X-Green/ELEC3300-Maglev-Project-2025/maglev2025_software/checklist.md

# Features

- ⚪️ADC Reading
  - CoilCurrent
  - InputVoltage
  - OverallCurrent
- ⚪️Coil Driving
- ⚪️MAG Reading
- ⚪️POSITION Control
- ⚪️RGB
- ⚪️Buzzer
- ⚪️Rotary Encoder
- ⚪️Voice UART
- ⚪️OLED
