X-Green/ELEC3300-Maglev-Project-2025/maglev2025_mech/Base_board/Base_board_3DP.SLDPRT

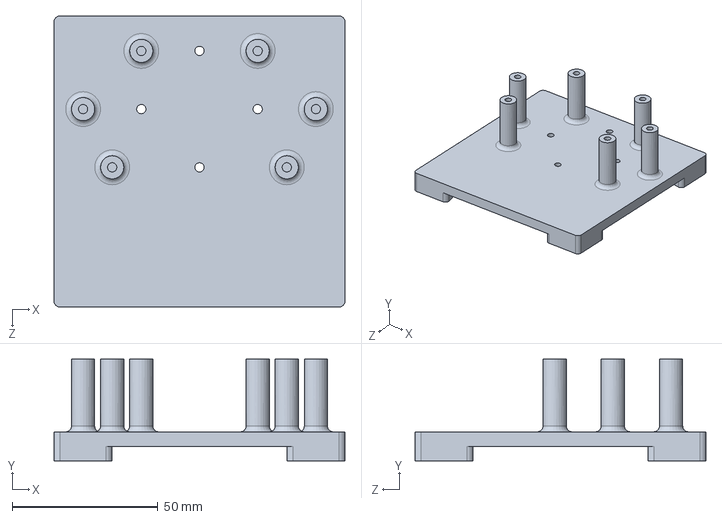
[picture p1: CAD file, 2025-04-16]
maglev2025_mech/Base_board/Base_board_3DP.SLDPRT
100.0 x 35.0 x 100.0 mm
