X-Green/ELEC3300-Maglev-Project-2025/maglev2025_hardware_sensor/maglev2025_hardware_sensor.kicad_pcb

## KiCad design maglev2025_hardware_sensor/maglev2025_hardware_sensor.kicad_pcb (2025-04-24)

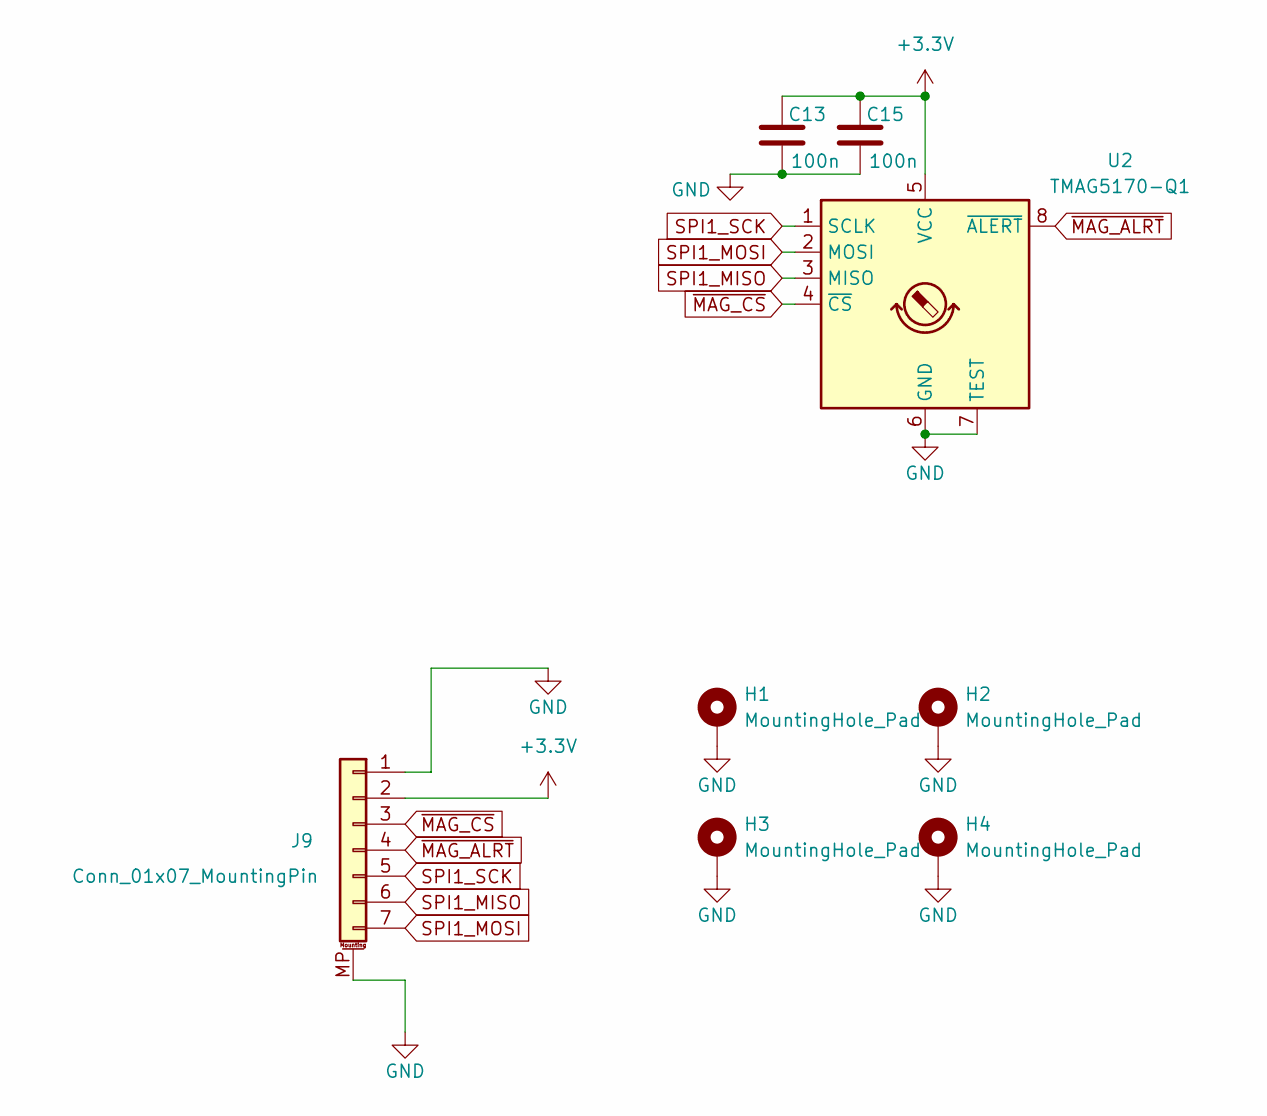
[picture p2: schematic maglev2025_hardware_sensor.kicad_sch]

Parts:
C13, C15: 100n; C_0603_1608Metric
H1, H2, H3, H4: MountingHole_Pad; MountingHole_2.2mm_M2_Pad_Via
J9: Conn_01x07_MountingPin; JST_GH_SM07B-GHS-TB_1x07-1MP_P1.25mm_Horizontal
U2: TMAG5170-Q1; VSSOP-8_3x3mm_P0.65mm

Connections:
+3.3V: C13.1, C15.1, J9.2, U2.5 (VCC)
GND: C13.2, C15.2, H1.1, H2.1, H3.1, H4.1, J9.1, J9.MP (MountPin), U2.6 (GND), U2.7 (TEST)
SPI1_MISO: J9.6, U2.3 (MISO)
SPI1_MOSI: J9.7, U2.2 (MOSI)
SPI1_SCK: J9.5, U2.1 (SCLK)
~MAG_ALRT: J9.4, U2.8 (~ALERT)
~MAG_CS: J9.3, U2.4 (~CS)

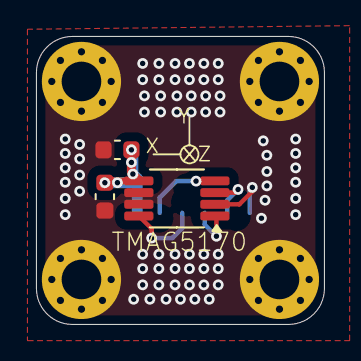
[picture p3: board maglev2025_hardware_sensor.kicad_pcb from above]

Board: 2 copper layers, 16.0 x 16.0 mm, 8 parts (1 on the bottom side), 7 nets.
