X-Green/ELEC3300-Maglev-Project-2025/maglev2025_hardware_test2/maglev2025_hardware_test2.kicad_pcb

## KiCad design maglev2025_hardware_test2/maglev2025_hardware_test2.kicad_pcb (2025-04-24)

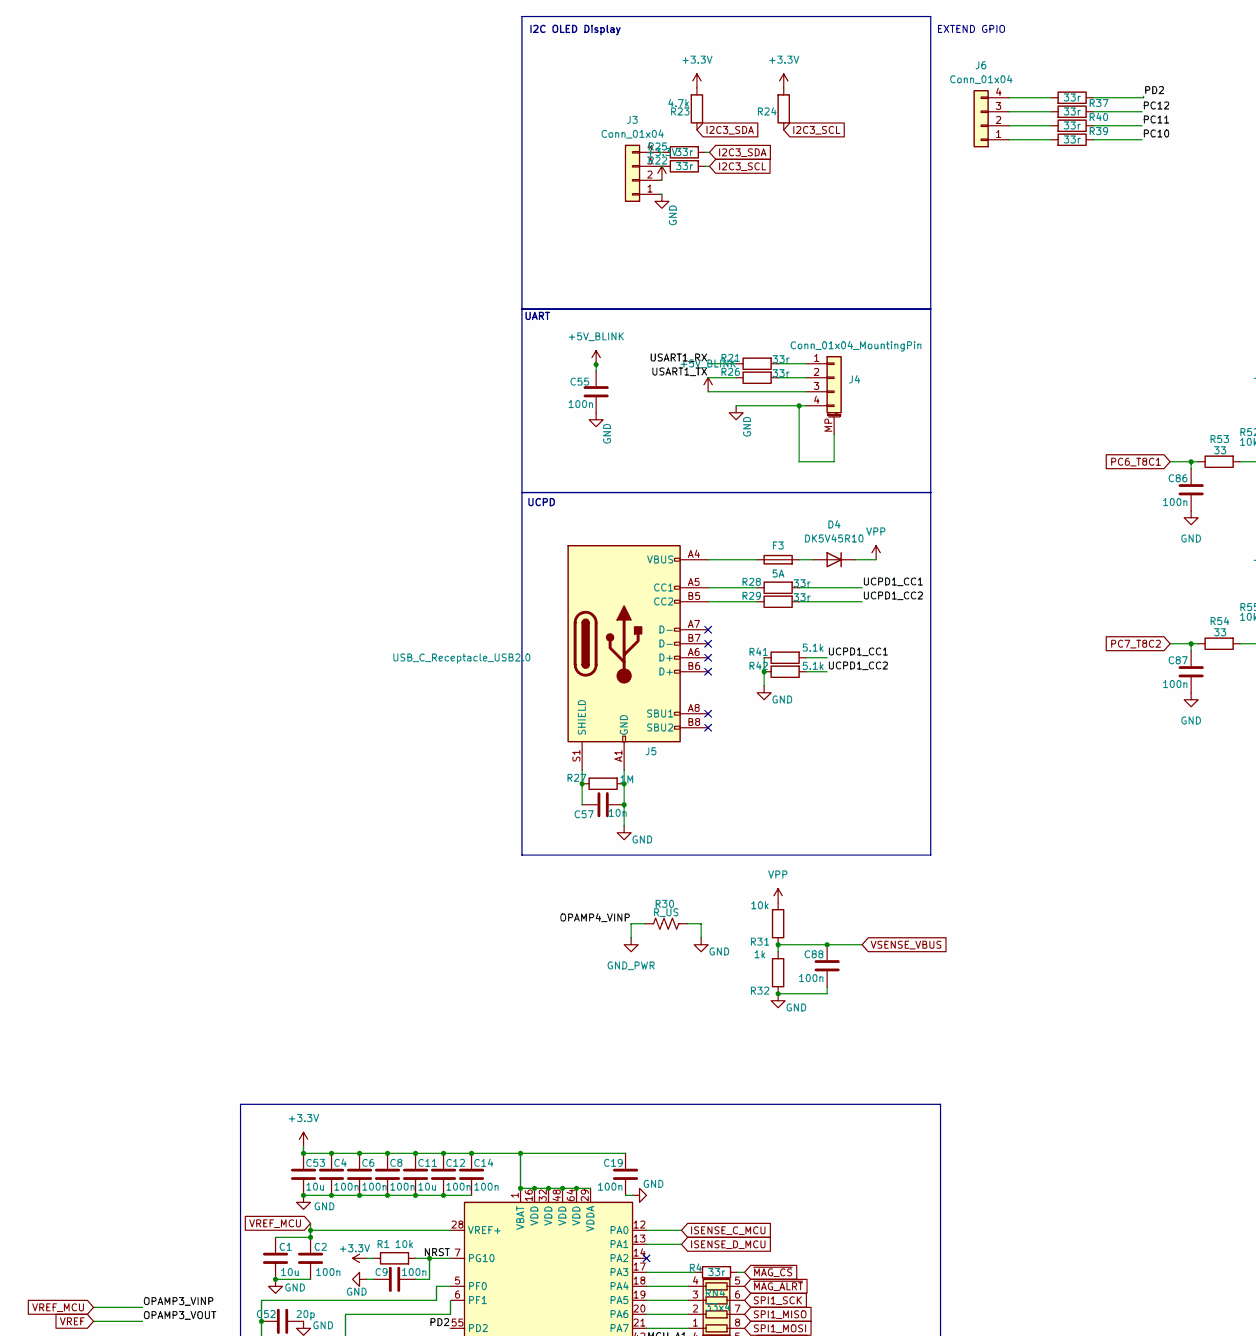
[picture p4: schematic maglev2025_hardware_test2.kicad_sch, part in row 1, column 1]

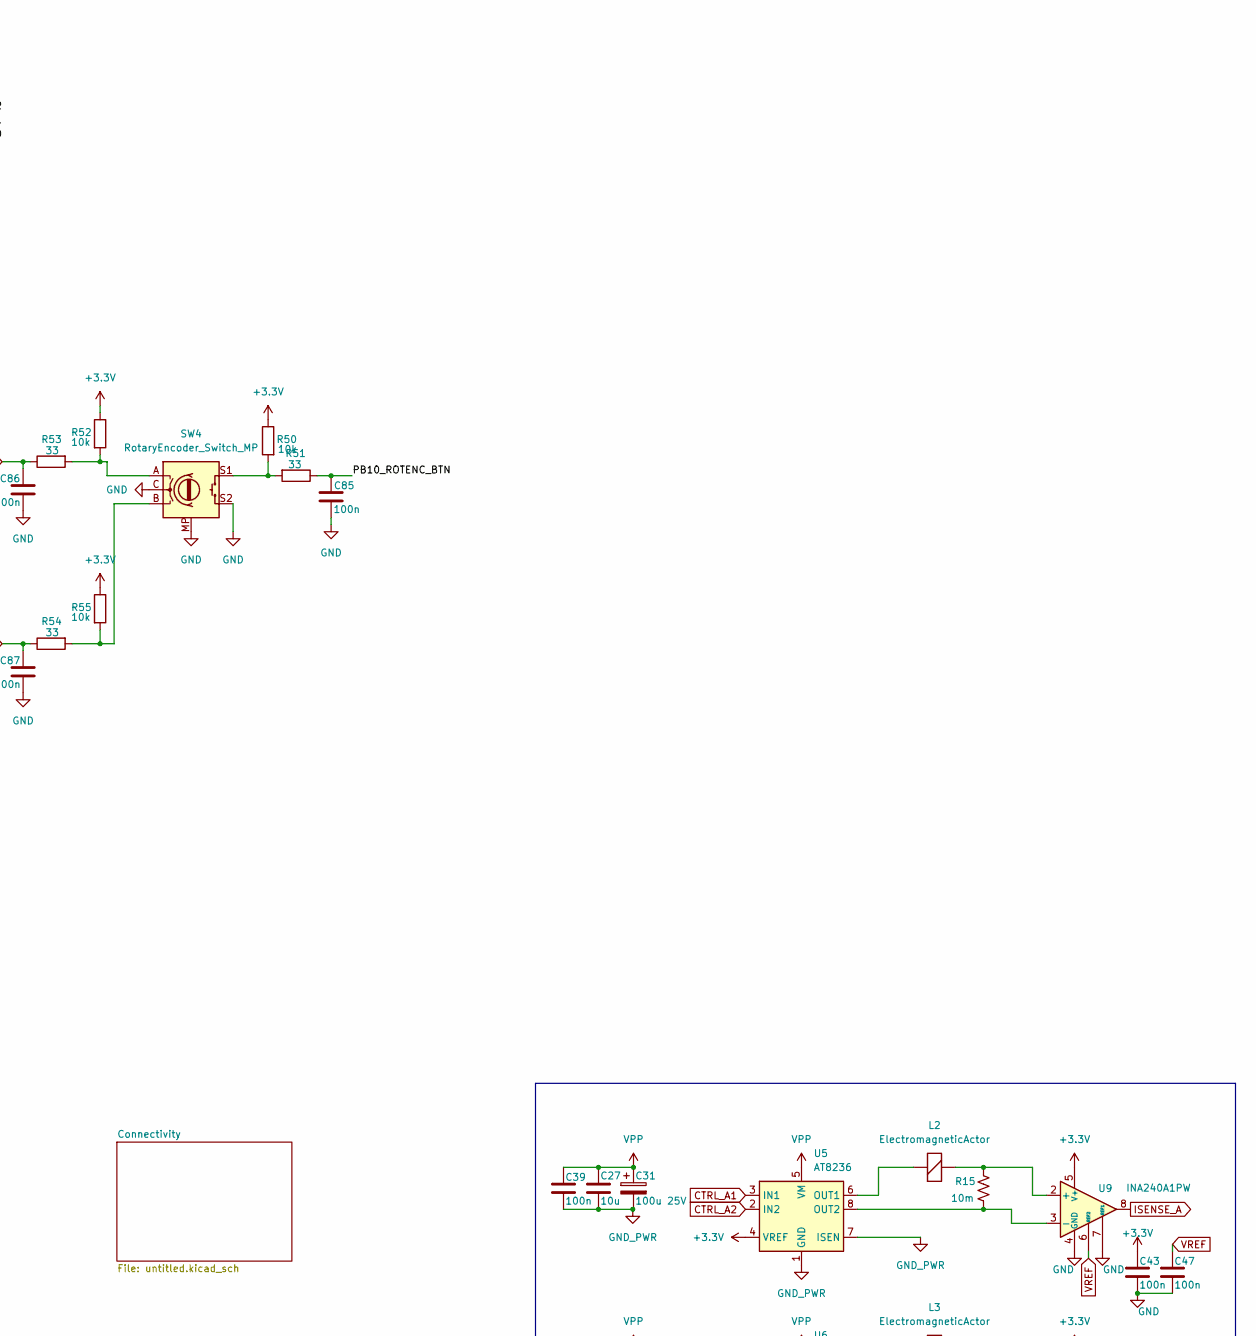
[picture p5: schematic maglev2025_hardware_test2.kicad_sch, part in row 1, column 2]

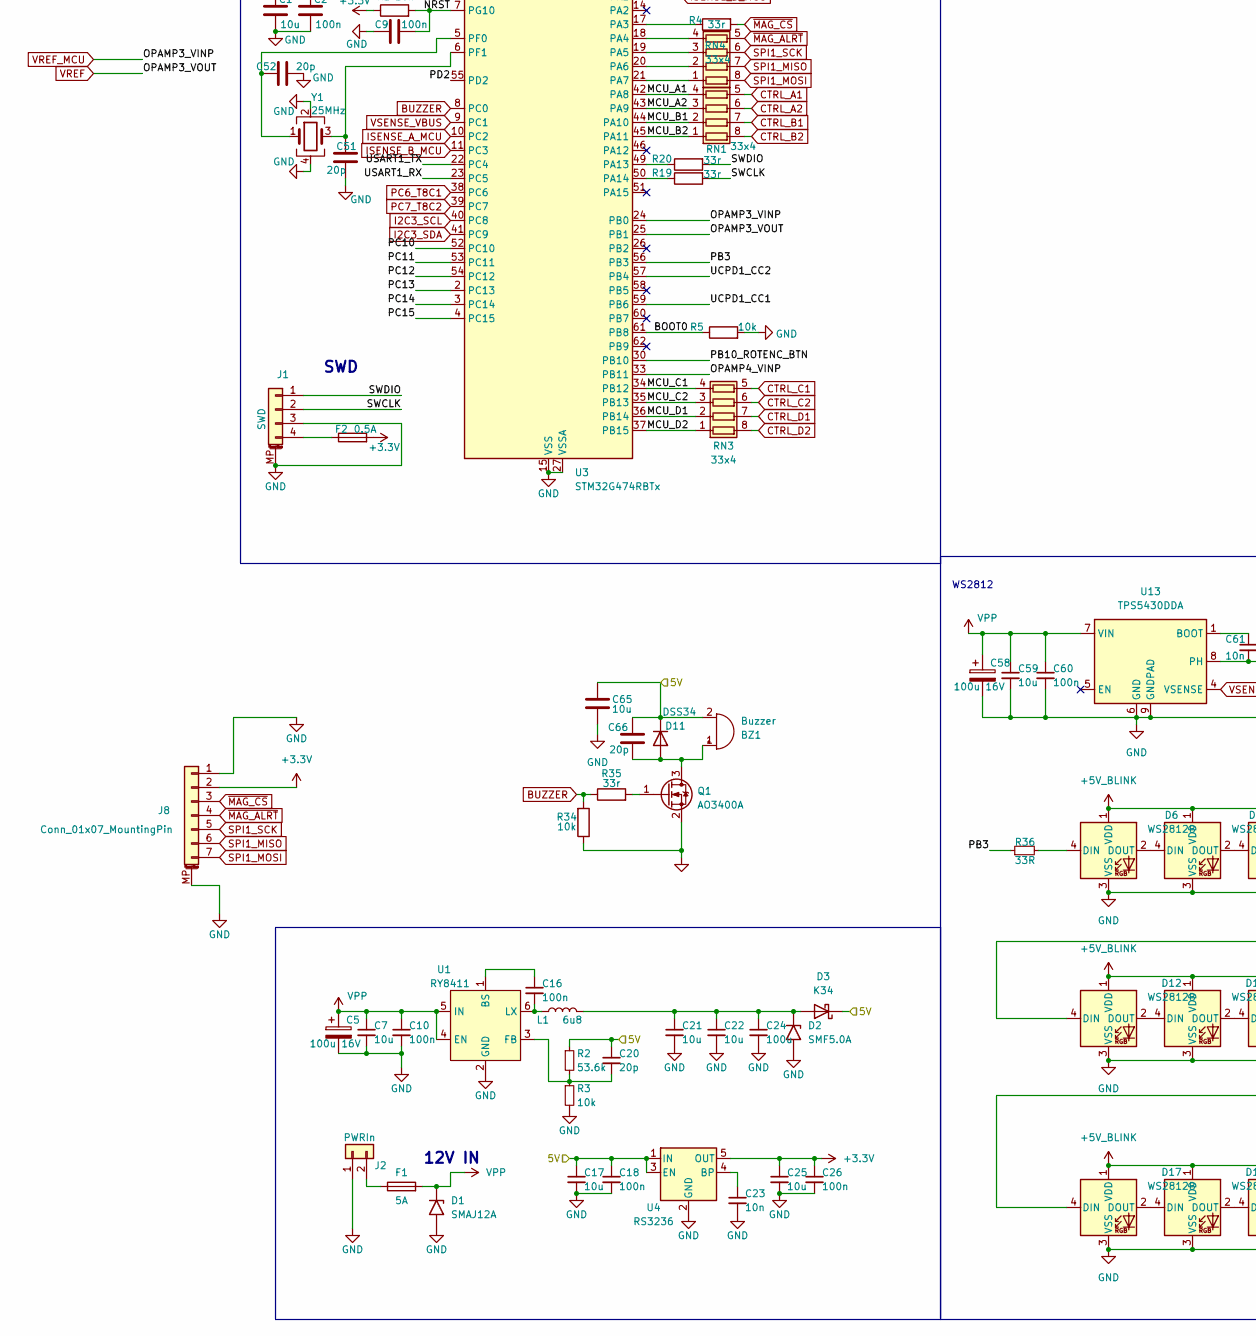
[picture p6: schematic maglev2025_hardware_test2.kicad_sch, part in row 2, column 1]

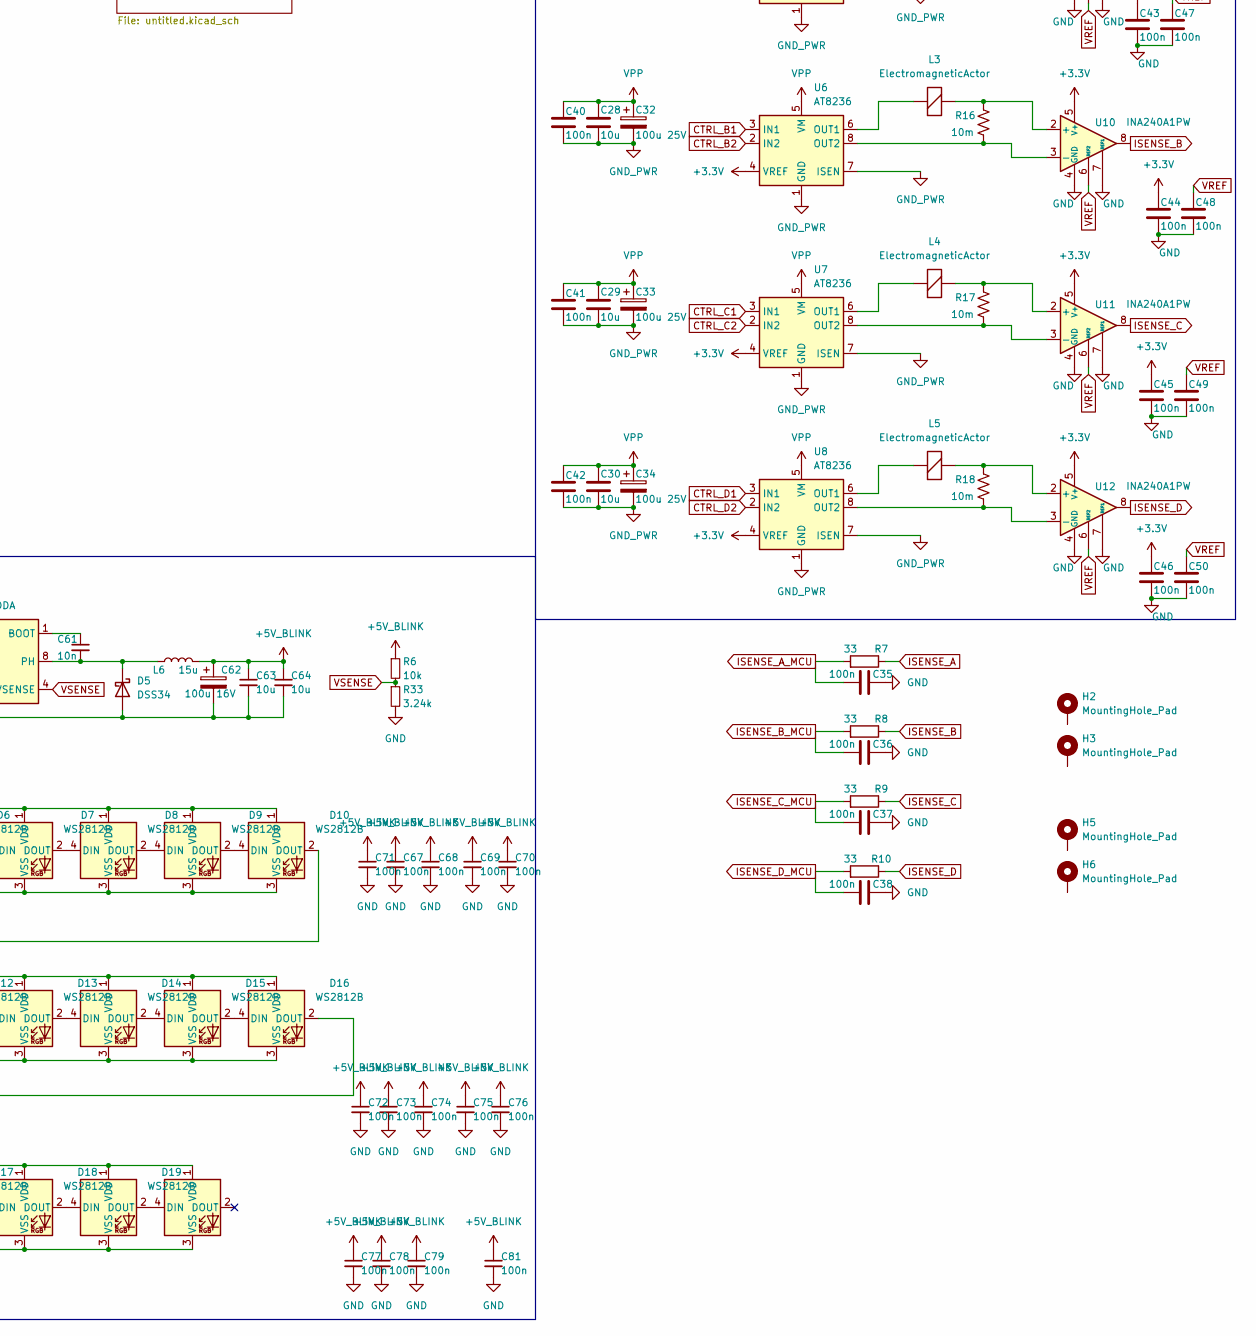
[picture p7: schematic maglev2025_hardware_test2.kicad_sch, part in row 2, column 2]

Parts:
BZ1: Buzzer; MLT-9032
C1, C11, C17, C25, C53, C65: 10u; C_0603_1608Metric
C2, C4, C6, C8, C9, C10, C12, C14, C16, C18, C19, C26, C35, C36, C37, C38, C39, C40, C41, C42, C43, C44, C45, C46, C47, C48, C49, C50, C55, C60, C67, C68, C69, C70, C71, C72, C73, C74, C75, C76, C77, C78, C79, C81, C85, C86, C87, C88: 100n; C_0603_1608Metric
C5, C58, C62: 100u 16V; CP_Radial_D6.3mm_P2.50mm
C7, C21, C22, C27, C28, C29, C30, C59, C63, C64: 10u; C_1206_3216Metric
C20, C51, C52, C66: 20p; C_0603_1608Metric
C23, C57, C61: 10n; C_0603_1608Metric
C24: 100u; C_2220_5750Metric
C31, C32, C33, C34: 100u 25V; CP_Radial_D6.3mm_P2.50mm
D1: SMAJ12A; D_SMA
D2: SMF5.0A; D_SMF
D3: K34; D_SOD-123F
D4: DK5V45R10; D_PowerDI-5
D5: DSS34; D_SMA
D6, D7, D8, D9, D10, D12, D13, D14, D15, D16, D17, D18, D19, D20: WS2812B; LED_WS2812B_PLCC4_5.0x5.0mm_P3.2mm
D11: DSS34; D_SMF
F1, F3: 5A; Fuse_1206_3216Metric
F2: 0.5A; Fuse_1206_3216Metric
H2, H3, H5, H6: MountingHole_Pad; MountingHole_3.2mm_M3_DIN965_Pad_TopBottom
J1: SWD; Molex_PicoBlade_53261-0471_1x04-1MP_P1.25mm_Horizontal
J2: PWRIn; AMASS_XT30U-M_1x02_P5.0mm_Vertical
J3, J6: Conn_01x04; PinHeader_1x04_P2.54mm_Vertical
J4: Conn_01x04_MountingPin; JST_GH_BM04B-GHS-TBT_1x04-1MP_P1.25mm_Vertical
J5: USB_C_Receptacle_USB2.0; USB_C_Receptacle_HRO_TYPE-C-31-M-12
J8: Conn_01x07_MountingPin; JST_GH_SM07B-GHS-TB_1x07-1MP_P1.25mm_Horizontal
L1: 6u8; L_Sunlord_MWSA0402S
L2, L3, L4, L5: ElectromagneticActor; JST_PH_B2B-PH-K_1x02_P2.00mm_Vertical
L6: 15u; L_Chilisin_BMRx00060630
Q1: AO3400A; SOT-23
R1, R3, R5, R6, R31, R34, R50, R52, R55: 10k; R_0603_1608Metric
R2: 53.6k; R_0603_1608Metric
R4, R19, R20, R21, R22, R25, R26, R28, R29, R35, R37, R38, R39, R40: 33r; R_0603_1608Metric
R7, R8, R9, R10, R51, R53, R54: 33; R_0603_1608Metric
R15, R16, R17, R18: 10m; R_2512_6332Metric
R23, R24: 4.7k; R_0603_1608Metric
R27: 1M; R_0603_1608Metric
R30: R_US; R_2512_6332Metric
R32: 1k; R_0603_1608Metric
R33: 3.24k; R_0603_1608Metric
R36: 33R; R_0603_1608Metric
R41, R42: 5.1k; R_0603_1608Metric
RN1, RN3, RN4: 33x4; R_Array_Convex_4x0603
SW4: RotaryEncoder_Switch_MP; RotaryEncoder_Alps_EC11E-Switch_Vertical_H20mm_MountingHoles
U1: RY8411; SOT-23-6
U3: STM32G474RBTx; LQFP-64_10x10mm_P0.5mm
U4: RS3236; SOT-23-5
U5, U6, U7, U8: AT8236; Texas_HTSOP-8-1EP_3.9x4.9mm_P1.27mm_EP2.95x4.9mm_Mask2.4x3.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
U9, U10, U11, U12: INA240A1PW; TSSOP-8_4.4x3mm_P0.65mm
U13: TPS5430DDA; TI_SO-PowerPAD-8_ThermalVias
Y1: 25MHz; Crystal_SMD_3225-4Pin_3.2x2.5mm

Connections:
+3.3V: C4.1, C6.1, C8.1, C11.1, C12.1, C14.1, C19.1, C25.1, C26.1, C43.1, C44.1, C45.1, C46.1, C53.1, F2.2, J3.2, J8.2, R1.1, R23.2, R24.2, R50.1, R52.1, R55.1, U3.1 (VBAT), U3.16 (VDD), U3.29 (VDDA), U3.32 (VDD), U3.48 (VDD), U3.64 (VDD), U4.5 (OUT), U5.4 (VREF), U6.4 (VREF), U7.4 (VREF), U8.4 (VREF), U9.5 (V+), U10.5 (V+), U11.5 (V+), U12.5 (V+)
+5V_BLINK: C55.1, C62.1, C63.1, C64.1, C67.1, C68.1, C69.1, C70.1, C71.1, C72.1, C73.1, C74.1, C75.1, C76.1, C77.1, C78.1, C79.1, C81.1, D6.1 (VDD), D7.1 (VDD), D8.1 (VDD), D9.1 (VDD), D10.1 (VDD), D12.1 (VDD), D13.1 (VDD), D14.1 (VDD), D15.1 (VDD), D16.1 (VDD), D17.1 (VDD), D18.1 (VDD), D19.1 (VDD), D20.1 (VDD), J4.3, L6.2, R6.1
/5V: BZ1.2 (+), C17.1, C18.1, C20.1, C65.1, C66.1, D3.1 (K), D11.1 (K), R2.1, U4.1 (IN), U4.3 (EN)
/BOOT0: R5.1, U3.61 (PB8)
/MCU_A1: RN1.4 (R4.1), U3.42 (PA8)
/MCU_A2: RN1.3 (R3.1), U3.43 (PA9)
/MCU_B1: RN1.2 (R2.1), U3.44 (PA10)
/MCU_B2: RN1.1 (R1.1), U3.45 (PA11)
/MCU_C1: RN3.4 (R4.1), U3.34 (PB12)
/MCU_C2: RN3.3 (R3.1), U3.35 (PB13)
/MCU_D1: RN3.2 (R2.1), U3.36 (PB14)
/MCU_D2: RN3.1 (R1.1), U3.37 (PB15)
/NRST: C9.2, R1.2, U3.7 (PG10)
/PB3: R36.1, U3.56 (PB3)
/PB10_ROTENC_BTN: C85.2, R51.1, U3.30 (PB10)
/PC10: R38.1, U3.52 (PC10)
/PC11: R39.1, U3.53 (PC11)
/PC12: R40.1, U3.54 (PC12)
/PC13: U3.2 (PC13)
/PC14: U3.3 (PC14)
/PC15: U3.4 (PC15)
/PD2: R37.1, U3.55 (PD2)
/SWCLK: J1.2, R19.2
/SWDIO: J1.1, R20.2
/UCPD1_CC1: R28.2, R41.2, U3.59 (PB6)
/UCPD1_CC2: R29.2, R42.2, U3.57 (PB4)
/USART1_RX: R21.1, U3.23 (PC5)
/USART1_TX: R26.1, U3.22 (PC4)
BUZZER: R34.2, R35.1, U3.8 (PC0)
CTRL_A1: RN1.5 (R4.2), U5.3 (IN1)
CTRL_A2: RN1.6 (R3.2), U5.2 (IN2)
CTRL_B1: RN1.7 (R2.2), U6.3 (IN1)
CTRL_B2: RN1.8 (R1.2), U6.2 (IN2)
CTRL_C1: RN3.5 (R4.2), U7.3 (IN1)
CTRL_C2: RN3.6 (R3.2), U7.2 (IN2)
CTRL_D1: RN3.7 (R2.2), U8.3 (IN1)
CTRL_D2: RN3.8 (R1.2), U8.2 (IN2)
GND: C1.2, C2.2, C4.2, C5.2, C6.2, C7.2, C8.2, C9.1, C10.2, C11.2, C12.2, C14.2, C17.2, C18.2, C19.2, C21.2, C22.2, C23.2, C24.2, C25.2, C26.2, C35.1, C36.1, C37.1, C38.1, C43.2, C44.2, C45.2, C46.2, C47.2, C48.2, C49.2, C50.2, C51.2, C52.2, C53.2, C55.2, C57.2, C58.2, C59.2, C60.2, C62.2, C63.2, C64.2, C65.2, C67.2, C68.2, C69.2, C70.2, C71.2, C72.2, C73.2, C74.2, C75.2, C76.2, C77.2, C78.2, C79.2, C81.2, C85.1, C86.1, C87.1, C88.1, D1.2 (A2), D2.2 (A2), D5.2 (A), D6.3 (VSS), D7.3 (VSS), D8.3 (VSS), D9.3 (VSS), D10.3 (VSS), D12.3 (VSS), D13.3 (VSS), D14.3 (VSS), D15.3 (VSS), D16.3 (VSS), D17.3 (VSS), D18.3 (VSS), D19.3 (VSS), D20.3 (VSS), J1.3, J1.MP (MountPin), J2.1, J3.1, J4.4, J4.MP (MountPin), J5.A1 (GND), J5.A12 (GND), J5.B1 (GND), J5.B12 (GND), J8.1, J8.MP (MountPin), Q1.2 (S), R3.2, R5.2, R27.2, R30.2, R32.1, R33.2, R34.1, R41.1, R42.1, SW4.C, SW4.MP, SW4.S2, U1.2 (GND), U3.15 (VSS), U3.27 (VSSA), U3.31 (VSS), U3.47 (VSS), U3.63 (VSS), U4.2 (GND), U9.1 (GND), U9.4 (GND), U9.7 (REF1), U10.1 (GND), U10.4 (GND), U10.7 (REF1), U11.1 (GND), U11.4 (GND), U11.7 (REF1), U12.1 (GND), U12.4 (GND), U12.7 (REF1), U13.6 (GND), U13.9 (GNDPAD), Y1.2, Y1.4
GND_PWR: C27.2, C28.2, C29.2, C30.2, C31.2, C32.2, C33.2, C34.2, C39.2, C40.2, C41.2, C42.2, R30.1, U3.33 (PB11), U5.1 (GND), U5.7 (ISEN), U5.9 (GND), U6.1 (GND), U6.7 (ISEN), U6.9 (GND), U7.1 (GND), U7.7 (ISEN), U7.9 (GND), U8.1 (GND), U8.7 (ISEN), U8.9 (GND)
I2C3_SCL: R22.2, R24.1, U3.40 (PC8)
I2C3_SDA: R23.1, R25.2, U3.41 (PC9)
ISENSE_A: R7.1, U9.8
ISENSE_A_MCU: C35.2, R7.2, U3.10 (PC2)
ISENSE_B: R8.1, U10.8
ISENSE_B_MCU: C36.2, R8.2, U3.11 (PC3)
ISENSE_C: R9.1, U11.8
ISENSE_C_MCU: C37.2, R9.2, U3.12 (PA0)
ISENSE_D: R10.1, U12.8
ISENSE_D_MCU: C38.2, R10.2, U3.13 (PA1)
unnamed: BZ1.1 (-), C66.2, D11.2 (A), Q1.3 (D)
unnamed: C21.1, C22.1, C24.1, D2.1 (A1), D3.2 (A), L1.2
unnamed: D4.2 (A), F3.2
unnamed: C61.2, D5.1 (K), L6.1, U13.8 (PH)
unnamed: D6.4 (DIN), R36.2
unnamed: D6.2 (DOUT), D7.4 (DIN)
unnamed: D7.2 (DOUT), D8.4 (DIN)
unnamed: D8.2 (DOUT), D9.4 (DIN)
unnamed: D9.2 (DOUT), D10.4 (DIN)
unnamed: D10.2 (DOUT), D12.4 (DIN)
unnamed: D12.2 (DOUT), D13.4 (DIN)
unnamed: D13.2 (DOUT), D14.4 (DIN)
unnamed: D14.2 (DOUT), D15.4 (DIN)
unnamed: D15.2 (DOUT), D16.4 (DIN)
unnamed: D16.2 (DOUT), D17.4 (DIN)
unnamed: D17.2 (DOUT), D18.4 (DIN)
unnamed: D18.2 (DOUT), D19.4 (DIN)
unnamed: D19.2 (DOUT), D20.4 (DIN)
unnamed: F3.1, J5.A4 (VBUS), J5.A9 (VBUS), J5.B4 (VBUS), J5.B9 (VBUS)
unnamed: F2.1, J1.4
unnamed: F1.1, J2.2
unnamed: J3.3, R22.1
unnamed: J3.4, R25.1
unnamed: J4.1, R21.2
unnamed: J4.2, R26.2
unnamed: J5.A5 (CC1), R28.1
unnamed: J5.B5 (CC2), R29.1
unnamed: C57.1, J5.S1 (SHIELD), R27.1
unnamed: J6.1, R38.2
unnamed: J6.2, R39.2
unnamed: J6.3, R40.2
unnamed: J6.4, R37.2
unnamed: L2.2 (+), R15.1, U9.2 (+)
unnamed: L2.1 (-), U5.6 (OUT1)
unnamed: L3.2 (+), R16.1, U10.2 (+)
unnamed: L3.1 (-), U6.6 (OUT1)
unnamed: L4.2 (+), R17.1, U11.2 (+)
unnamed: L4.1 (-), U7.6 (OUT1)
unnamed: L5.2 (+), R18.1, U12.2 (+)
unnamed: L5.1 (-), U8.6 (OUT1)
unnamed: Q1.1 (G), R35.2
unnamed: R50.2, R51.2, SW4.S1
unnamed: R52.2, R53.2, SW4.A
unnamed: R54.2, R55.2, SW4.B
unnamed: RN4.1 (R1.1), U3.21 (PA7)
unnamed: RN4.2 (R2.1), U3.20 (PA6)
unnamed: RN4.3 (R3.1), U3.19 (PA5)
unnamed: RN4.4 (R4.1), U3.18 (PA4)
unnamed: C16.1, U1.1 (BS)
unnamed: C20.2, R2.2, R3.1, U1.3 (FB)
unnamed: C16.2, L1.1, U1.6 (LX)
unnamed: R4.1, U3.17 (PA3)
unnamed: R20.1, U3.49 (PA13)
unnamed: R19.1, U3.50 (PA14)
unnamed: C52.1, U3.5 (PF0), Y1.1
unnamed: C51.1, U3.6 (PF1), Y1.3
unnamed: C23.1, U4.4 (BP)
unnamed: R15.2, U5.8 (OUT2), U9.3 (-)
unnamed: R16.2, U6.8 (OUT2), U10.3 (-)
unnamed: R17.2, U7.8 (OUT2), U11.3 (-)
unnamed: R18.2, U8.8 (OUT2), U12.3 (-)
unnamed: C61.1, U13.1 (BOOT)
PC6_T8C1: C86.2, R53.1, U3.38 (PC6)
PC7_T8C2: C87.2, R54.1, U3.39 (PC7)
SPI1_MISO: J8.6, RN4.7 (R2.2)
SPI1_MOSI: J8.7, RN4.8 (R1.2)
SPI1_SCK: J8.5, RN4.6 (R3.2)
VPP: C5.1, C7.1, C10.1, C27.1, C28.1, C29.1, C30.1, C31.1, C32.1, C33.1, C34.1, C39.1, C40.1, C41.1, C42.1, C58.1, C59.1, C60.1, D1.1 (A1), D4.1 (K), F1.2, R31.2, U1.4 (EN), U1.5 (IN), U5.5 (VM), U6.5 (VM), U7.5 (VM), U8.5 (VM), U13.7 (VIN)
VREF: C47.1, C48.1, C49.1, C50.1, U3.25 (PB1), U9.6 (REF2), U10.6 (REF2), U11.6 (REF2), U12.6 (REF2)
VREF_MCU: C1.1, C2.1, U3.24 (PB0), U3.28 (VREF+)
VSENSE: R6.2, R33.1, U13.4 (VSENSE)
VSENSE_VBUS: C88.2, R31.1, R32.2, U3.9 (PC1)
~MAG_ALRT: J8.4, RN4.5 (R4.2)
~MAG_CS: J8.3, R4.2

Notes on the sheet:
12V IN
UCPD
UART
I2C OLED Display
SWD
EXTEND GPIO
WS2812

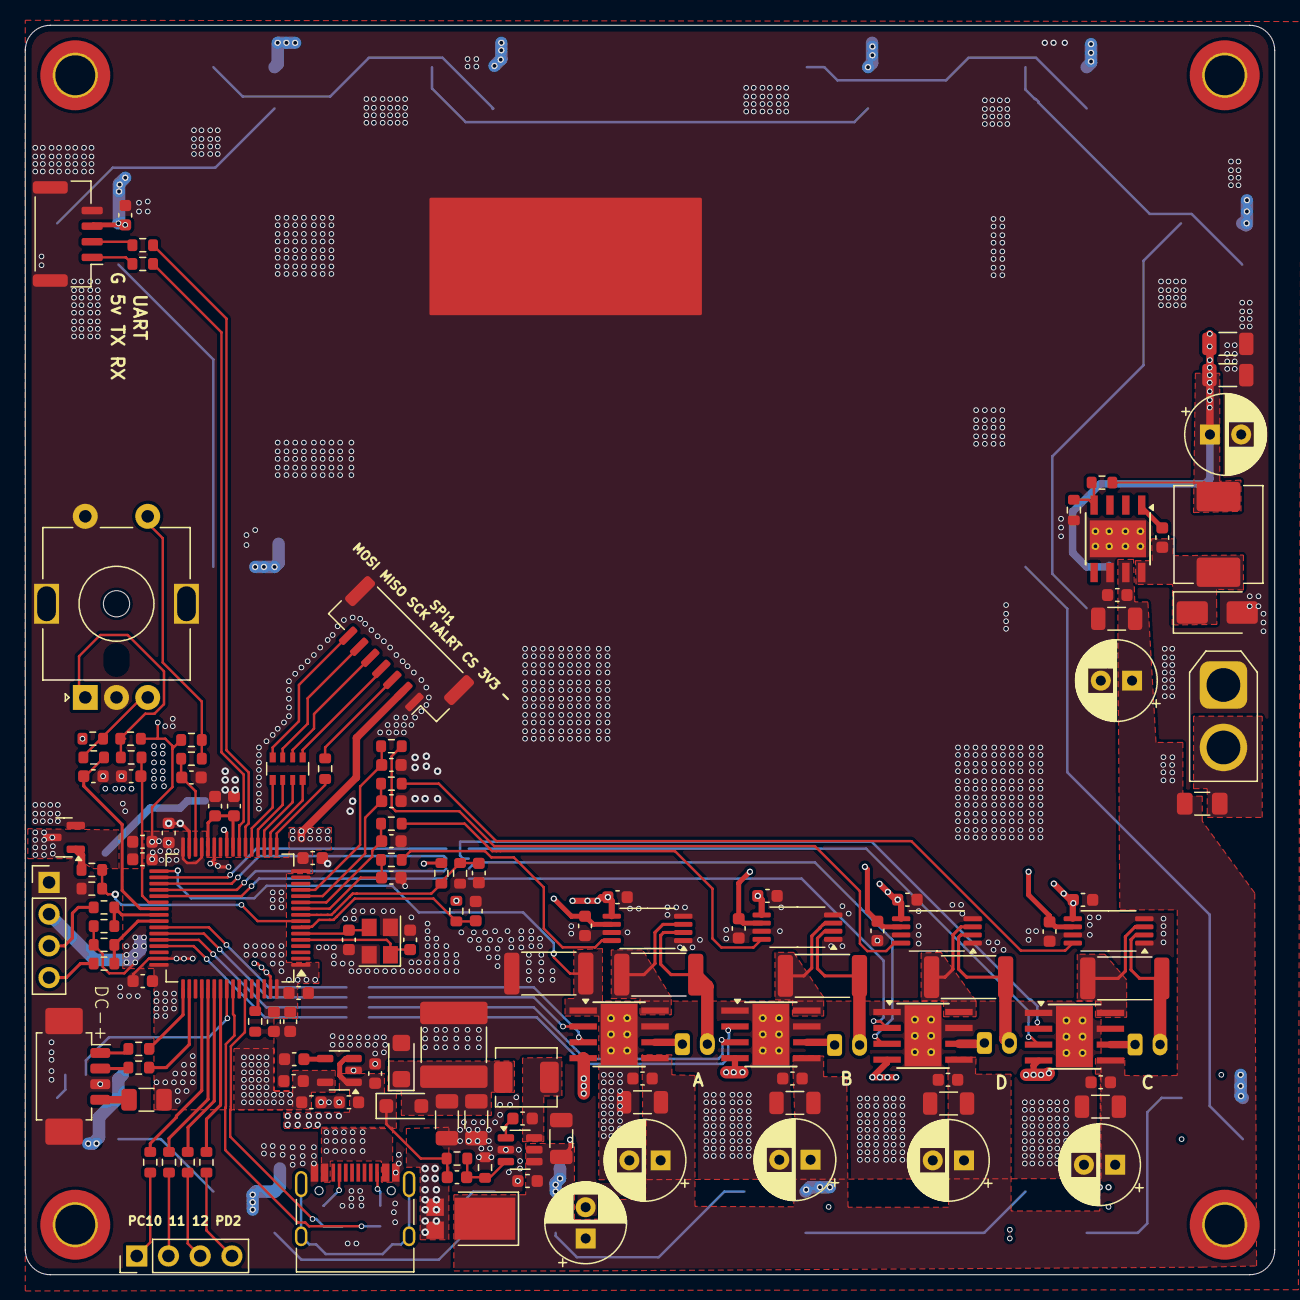
[picture p8: board maglev2025_hardware_test2.kicad_pcb from above]

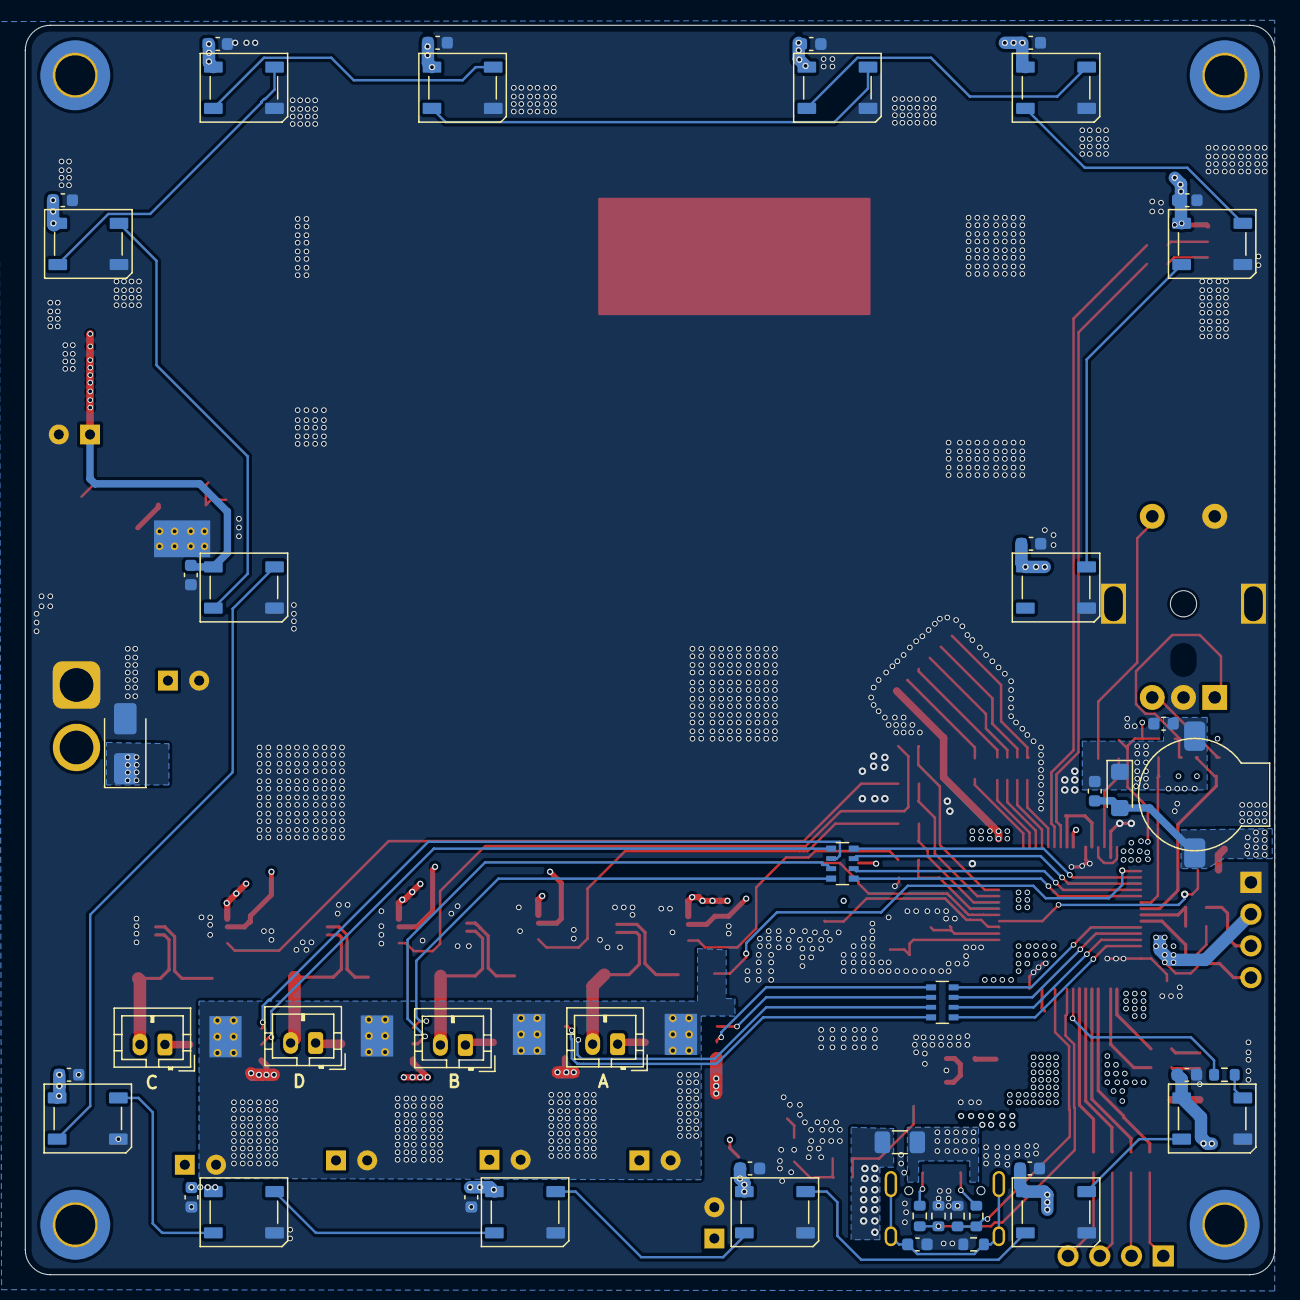
[picture p9: board maglev2025_hardware_test2.kicad_pcb from below]

Board: 4 copper layers, 100.0 x 100.0 mm, 182 parts (47 on the bottom side), 120 nets.
