X-Green/ELEC3300-Maglev-Project-2025/maglev2025_software/Tasks/MainTasks.cpp

#include "Buzzer.hpp"
#include "CoilManager.hpp"
#include "CommandInput.hpp"
#include "DisplayTasks.hpp"
#include "ErrorChecker.hpp"
#include "LEDTasks.hpp"
#include "MusicTasks.hpp"
#include "PositionControl.hpp"
#include "SampleTask.hpp"
#include "TMAG5170.hpp"
#include "WS2812.hpp"
#include "adc.h"
#include "dma.h"
#include "hrtim.h"
#include "opamp.h"
#include "spi.h"
#include "stm32g4xx_it.h"
#include "usart.h"
// extern "C" void DMA_SPI1_RX_CompleteCallback(DMA_HandleTypeDef *hdma);
// extern DMA_HandleTypeDef hdma_spi1_rx;

namespace MainTask
{

bool initialized               = false;
volatile uint16_t adcBuffer[4] = {0, 0, 0, 0};

void init()
{
    Drivers::Sensors::TMAG5170::TMAG5170_init();
    Drivers::Sensors::TMAG5170::setDeviceConfig();
    Drivers::Sensors::TMAG5170::setSensorConfig();
    Drivers::Sensors::TMAG5170::alertIndicatesConversionEnable();
    Drivers::Sensors::TMAG5170::initDMATxBuffers();

    Tasks::SampleTask::sampleTaskInit();

    Tasks::CommandInput::initCommandInput();

    HAL_Delay(100);

    HAL_TIM_Base_Start_IT(&htim17);

    __HAL_HRTIM_MASTER_ENABLE_IT(&hhrtim1, HRTIM_MASTER_IT_MREP);  // enable master repetition interrupt
    HAL_HRTIM_WaveformCountStart(&hhrtim1, HRTIM_TIMERID_MASTER);
    HAL_HRTIM_WaveformCountStart(&hhrtim1, HRTIM_TIMERID_TIMER_A);
    HAL_HRTIM_WaveformCountStart(&hhrtim1, HRTIM_TIMERID_TIMER_B);
    HAL_HRTIM_WaveformCountStart(&hhrtim1, HRTIM_TIMERID_TIMER_C);
    HAL_HRTIM_WaveformCountStart(&hhrtim1, HRTIM_TIMERID_TIMER_D);
    Tasks::CoilManager::setOutputEnable();

    HAL_Delay(100);

    Drivers::WS2812::init();

    Drivers::Buzzer::init();

    Drivers::DisplayTasks::DisplayInit();
    initialized = true;

    Drivers::Buzzer::play(1000, 400);
    HAL_Delay(1000);
    Drivers::Buzzer::play(2000, 100);
    HAL_Delay(200);
    Drivers::Buzzer::play(2000, 100);
    HAL_Delay(200);
    Drivers::Buzzer::play(2000, 100);
    HAL_Delay(1000);

    // Drivers::Oled::OLED_Init();
    // Drivers::Oled::OLED_On();
    // // Drivers::Oled::OLED_ShowNum(48,4,6,1,16, 0);
    // Drivers::Oled::OLED_Clear();
    // HAL_Delay(100);
    // Drivers::Oled::OLED_DrawBMP(0,0,128, 8 ,epd_bitmap_GZS,0);

    // Drivers::Buzzer::play(330, 200);  // E4
    // HAL_Delay(250);
    // Drivers::Buzzer::play(330, 200);  // E4
    // HAL_Delay(250);
    // Drivers::Buzzer::play(349, 200);  // F4
    // HAL_Delay(250);
    // Drivers::Buzzer::play(392, 200);  // G4
    // HAL_Delay(250);
    // Drivers::Buzzer::play(392, 200);  // G4
    // HAL_Delay(250);
    // Drivers::Buzzer::play(349, 200);  // F4
    // HAL_Delay(250);
    // Drivers::Buzzer::play(330, 200);  // E4
    // HAL_Delay(250);
    // Drivers::Buzzer::play(294, 200);  // D4
    // HAL_Delay(250);
    // Drivers::Buzzer::play(262, 200);  // C4
    // HAL_Delay(250);
    // Drivers::Buzzer::play(262, 200);  // C4
    // HAL_Delay(250);
    // Drivers::Buzzer::play(294, 200);  // D4
    // HAL_Delay(250);
    // Drivers::Buzzer::play(330, 200);  // E4
    // HAL_Delay(250);
    // Drivers::Buzzer::play(330, 200);  // E4 (longer)
    // HAL_Delay(375);
    // Drivers::Buzzer::play(294, 100);  // D4
    // HAL_Delay(125);
    // Drivers::Buzzer::play(294, 200);  // D4 (longer)
    Tasks::Music::startMelody(Tasks::Music::melody1, sizeof(Tasks::Music::melody1) / sizeof(Tasks::Music::melody1[0]));

    HAL_Delay(2000);
}

volatile float testOutput   = 0.0f;
uint8_t fps                 = 0;
volatile uint8_t Page_state = 0;
void loop()
{
    // u8g2_SendBuffer(&u8g2);
    // u8g2_DrawBox(&u8g2,0,0,20,20);
    // u8g2_DrawBox(&u8g2,20,20,20,20);
    // u8g2_SendBuffer(&u8g2);
    // u8g2_DrawFrame(&u8g2,10,40,20,20);
    // u8g2_SendBuffer(&u8g2);
    // u8g2_SetFont(&u8g2,u8g2_font_DigitalDiscoThin_tf);
    // u8g2_DrawStr(&u8g2,30,32,"ELEC3300Project");
    // u8g2_DrawCircle(&u8g2, 30, 32, 10, U8G2_DRAW_UPPER_RIGHT);
    // u8g2_SendBuffer(&u8g2);
    Drivers::DisplayTasks::DisplayUpdate(Page_state);

    fps++;
    //    Drivers::Sensors::TMAG5170::getMagMeasurementsNrml(const_cast<float *>(magnetic_measurements));
}

void trigger1KHz()
{
    Tasks::SampleTask::callbackNormal();
    Tasks::ErrorChecker::updateErrorState();
    Tasks::LEDTasks::kHzTrigger();
    Tasks::Music::update1KHz();
}

void triggerOneHz()
{
    static volatile int oneHzCounter = 0;
    oneHzCounter += 1;
    Tasks::PositionControl::counterLogs.dataReadyCounter = 0;
    fps                                                  = 0;
}

}  // namespace MainTask

extern "C"
{
    /**
     * Called at main.c
     */
    [[noreturn]] void systemStart()
    {
        MainTask::init();
        for (;;)
            MainTask::loop();
    }

    /**
     * @brief HRTIM interrupt @ 85kHz
     */
    void HRTIM1_Master_IRQHandler(void)
    {
        __HAL_HRTIM_MASTER_CLEAR_IT(&hhrtim1, HRTIM_MASTER_IT_MREP);
        Tasks::SampleTask::callbackHRTIM();
        Tasks::CoilManager::updateCoilsFast();
        Tasks::ErrorChecker::updateErrorStateFast();
    }

    /**
     * @brief EXTI from MAG_CS, around 3kHz
     */
    void EXTI4_IRQHandler(void)
    {
        __HAL_GPIO_EXTI_CLEAR_FLAG(GPIO_PIN_4);
        if (!MainTask::initialized)
            return;
        Tasks::PositionControl::onDataReady();
    }

    void HAL_SPI_TxRxCpltCallback(SPI_HandleTypeDef *hspi)
    {
        if (!MainTask::initialized)
            return;

        if (HAL_SPI_GetState(&hspi1) != HAL_SPI_STATE_READY)
        {
            __asm("bkpt");
        }

        Drivers::Sensors::TMAG5170::continueDMASequentialNormalReadXYZ();
    }

    void TIM1_TRG_COM_TIM17_IRQHandler(void)
    {
        uint32_t itsource = htim17.Instance->DIER;
        uint32_t itflag   = htim17.Instance->SR;
        if ((itflag & (TIM_FLAG_UPDATE)) == (TIM_FLAG_UPDATE))
        {
            if ((itsource & (TIM_IT_UPDATE)) == (TIM_IT_UPDATE))
            {
                __HAL_TIM_CLEAR_FLAG(&htim17, TIM_FLAG_UPDATE);
                if (!MainTask::initialized)
                    return;
                MainTask::trigger1KHz();
                static uint32_t timerCounter1KHz = 0;
                timerCounter1KHz++;
                if (timerCounter1KHz > 1000)
                {
                    timerCounter1KHz = 0;
                    MainTask::triggerOneHz();
                }
            }
        }
    }

    void TIM1_UP_TIM16_IRQHandler(void) { Drivers::Buzzer::onTIM1UpdateCallback(); }

    void HAL_UARTEx_RxEventCallback(UART_HandleTypeDef *huart, uint16_t Size)
    {
        if (huart == &huart1)
        {
            Tasks::CommandInput::onU1RXCallback();
        }
        else
        {
            __asm("bkpt");
        }
    }
}
