X-Green/ELEC3300-Maglev-Project-2025/maglev2025_software/maglev2025_software.ioc

Mcu.UserName=STM32G474RBTx
PA0.GPIO_Label=A2I1_IBSENSE
PA0.Signal=ADC2_IN1
PA1.GPIO_Label=A2I2_IASENSE
PA1.Signal=ADC2_IN2
PA10.Signal=HRTIM1_CHB1
PA11.Signal=HRTIM1_CHB2
PA13.Signal=SYS_JTMS-SWDIO
PA14.Signal=SYS_JTCK-SWCLK
PA3.GPIO_Label=MAG_CS
PA3.Signal=GPIO_Output
PA4.GPIO_Label=nMAG_ALRT
PA4.Signal=GPXTI4
PA5.Signal=SPI1_SCK
PA6.Signal=SPI1_MISO
PA7.Signal=SPI1_MOSI
PA8.Signal=HRTIM1_CHA1
PA9.Signal=HRTIM1_CHA2
PB0.Signal=OPAMP3_VINP
PB1.Signal=OPAMP3_VOUT
PB10.Signal=GPIO_Input
PB11.Signal=OPAMP4_VINP
PB12.Signal=HRTIM1_CHC1
PB13.Signal=HRTIM1_CHC2
PB14.Signal=HRTIM1_CHD1
PB15.Signal=HRTIM1_CHD2
PB3.GPIO_Label=WS2812_T2C2
PB3.Signal=S_TIM2_CH2
PB4.Signal=UCPD1_CC2
PB6.Signal=UCPD1_CC1
PB8-BOOT0.GPIO_Label=BOOT0
PB8-BOOT0.Signal=GPIO_Input
PC0.Signal=S_TIM1_CH1
PC1.GPIO_Label=A1I7_VBUS
PC1.Signal=ADC1_IN7
PC2.GPIO_Label=A2I8_IDSENSE
PC2.Signal=ADC2_IN8
PC3.GPIO_Label=A2I9_ICSENSE
PC3.Signal=ADC2_IN9
PC4.Signal=USART1_TX
PC5.Signal=USART1_RX
PC6.Signal=S_TIM8_CH1
PC7.Signal=S_TIM8_CH2
PC8.Signal=I2C3_SCL
PC9.Signal=I2C3_SDA
PF0-OSC_IN.Signal=RCC_OSC_IN
PF1-OSC_OUT.Signal=RCC_OSC_OUT
