X-Green/ELEC3300-Maglev-Project-2025/maglev2025_software/Tasks/PositionControl.cpp

//
// Created by eeasee on 4/8/25.
//

#include "PositionControl.hpp"

#include "CoilManager.hpp"
#include "IncrementalPID.hpp"
#include "PID.hpp"
#include "TMAG5170.hpp"

// Utils::IncrementalPID positionPIDAxisX = Utils::IncrementalPID(0.000f, 0.004f, 0.000f, 0.001f);
// Utils::IncrementalPID positionPIDAxisY = Utils::IncrementalPID(0.000f, 0.004f, 0.000f, 0.001f);

Utils::PID positionPIDAxisX = Utils::PID(0.000f, 65.5f, 0.000f, 2305.0f, 0.9f, 1000.0f);
Utils::PID positionPIDAxisY = Utils::PID(0.000f, 65.5f, 0.000f, 2305.0f, 0.9f, 1000.0f);

float offsetCurrentX = 0.0f;  // A and C for X axis;
float offsetCurrentY = 0.0f;  // B and D for Y axis;

float globalOffsetCurrent = 0.0f;

// float targetX     = -0.011;
// float targetY     = 0.016f;
float targetX     = 0;
float targetY     = 0;
float realP       = 50.5f;
float realI       = 0.0000f;
float realD       = 2000.0f;
float lastX       = 0.0f;
float lastY       = 0.0f;
float integralX   = 0.0f;
float integralY   = 0.0f;
float derivativeX = 0.0f;
float derivativeY = 0.0f;
float errorX      = 0.0f;
float errorY      = 0.0f;

static float rotationAngle = 0.0f;                       // Current angle in radians
float radius               = 0.001f;                     // Circle radius
float angularVelocity      = 1.0f;                       // Radians per second
float angleIncrement       = angularVelocity / 2500.0f;  // At 2500 Hz

void Tasks::PositionControl::updatePosition()
{
    // running at 2500 hz

    // Increment the angle for next iteration
    rotationAngle += angleIncrement;
    // Wrap around when reaching 2π to prevent float overflow
    if (rotationAngle >= 2.0f * (float)(M_PI))
    {
        rotationAngle -= 2.0f * (float)M_PI;
    }

    offsetCurrentX = positionPIDAxisX.update(targetX + radius * cosf(rotationAngle), magMeasurement[0]);
    offsetCurrentY = positionPIDAxisY.update(targetY + radius * sinf(rotationAngle), magMeasurement[1]);

    // Which of A and C is x+?
    Tasks::CoilManager::coilTargetCurrent[0] = globalOffsetCurrent + offsetCurrentX;
    Tasks::CoilManager::coilTargetCurrent[2] = globalOffsetCurrent - offsetCurrentX;
    // To test
    Tasks::CoilManager::coilTargetCurrent[1] = globalOffsetCurrent + offsetCurrentY;
    Tasks::CoilManager::coilTargetCurrent[3] = globalOffsetCurrent - offsetCurrentY;
}

void Tasks::PositionControl::onDataReady()
{
    counterLogs.dataReadyCounter++;
    Drivers::Sensors::TMAG5170::startDMASequentialNormalReadXYZ();
}
