X-Green/ELEC3300-Maglev-Project-2025/maglev2025_software/Core/Inc/main.h

#define A1I7_VBUS_Pin GPIO_PIN_1
#define A1I7_VBUS_GPIO_Port GPIOC
#define A2I8_IDSENSE_Pin GPIO_PIN_2
#define A2I8_IDSENSE_GPIO_Port GPIOC
#define A2I9_ICSENSE_Pin GPIO_PIN_3
#define A2I9_ICSENSE_GPIO_Port GPIOC
#define A2I1_IBSENSE_Pin GPIO_PIN_0
#define A2I1_IBSENSE_GPIO_Port GPIOA
#define A2I2_IASENSE_Pin GPIO_PIN_1
#define A2I2_IASENSE_GPIO_Port GPIOA
#define MAG_CS_Pin GPIO_PIN_3
#define MAG_CS_GPIO_Port GPIOA
#define nMAG_ALRT_Pin GPIO_PIN_4
#define nMAG_ALRT_GPIO_Port GPIOA
#define nMAG_ALRT_EXTI_IRQn EXTI4_IRQn
#define WS2812_T2C2_Pin GPIO_PIN_3
#define WS2812_T2C2_GPIO_Port GPIOB
#define BOOT0_Pin GPIO_PIN_8
#define BOOT0_GPIO_Port GPIOB
