X-Green/ELEC3300-Maglev-Project-2025/maglev2025_software/Tasks/PositionControl.hpp

//
// Created by eeasee on 4/8/25.
//

#pragma once

namespace Tasks::PositionControl
{
void initPositionControl();

inline float magMeasurement[3] = {0, 0, 0};

struct CounterLogs
{
    int dataReadyCounter = 0;
};
inline CounterLogs counterLogs = {0};

/**
 * Unblockingly get data from MAG sensor
 */
void onDataReady();

/**
 *
 */
void updatePosition();

}  // namespace Tasks::PositionControl
