X-Green/ELEC3300-Maglev-Project-2025/maglev2025_software/Drivers/Oled.hpp

#pragma once
#include "i2c.h"
#include "u8g2/u8g2.h"

#define u8 unsigned char
#define MAX_LEN 128
#define OLED_ADDRESS 0x78
#define OLED_CMD 0x00
#define OLED_DATA 0x40

uint8_t u8x8_byte_hw_i2c(u8x8_t *u8x8, uint8_t msg, uint8_t arg_int, void *arg_ptr);
uint8_t u8x8_gpio_and_delay(u8x8_t *u8x8, uint8_t msg, uint8_t arg_int, void *arg_ptr);
void u8g2Init(u8g2_t *u8g2);
uint8_t *DataToWave(float *data, uint8_t len, uint8_t *wave, float max, float min);
void DrawWave(uint8_t x, uint8_t y, uint8_t *wave, uint8_t len, u8g2_t *u8g2);
void updateMagnetWaveform(float newValue, float *MagnetWaveform);

namespace Drivers::Oled
{

void OLED_WR_CMD(uint8_t cmd);
void OLED_Init(void);
void OLED_WR_DATA(uint8_t data);
void OLED_On(void);
void OLED_Display_On(void);
void OLED_Clear(void);
void OLED_Set_Pos(uint8_t x, uint8_t y);
unsigned int oled_pow(uint8_t m, uint8_t n);
void OLED_ShowChar(uint8_t x, uint8_t y, uint8_t chr, uint8_t Char_Size, uint8_t Color_Turn);
void OLED_ShowNum(uint8_t x, uint8_t y, unsigned int num, uint8_t len, uint8_t size2, uint8_t Color_Turn);
void OLED_DrawBMP(uint8_t x0, uint8_t y0, uint8_t x1, uint8_t y1, uint8_t *BMP, uint8_t Color_Turn);

void OLED_Draw3300(void);

}  // namespace Drivers::Oled

// oledfont
inline const unsigned char F6x8[][6] = {
    0x00, 0x00, 0x00, 0x00, 0x00, 0x00,  // sp
    0x00, 0x00, 0x00, 0x2f, 0x00, 0x00,  // !
    0x00, 0x00, 0x07, 0x00, 0x07, 0x00,  // "
    0x00, 0x14, 0x7f, 0x14, 0x7f, 0x14,  // #
    0x00, 0x24, 0x2a, 0x7f, 0x2a, 0x12,  // $
    0x00, 0x62, 0x64, 0x08, 0x13, 0x23,  // %
    0x00, 0x36, 0x49, 0x55, 0x22, 0x50,  // &
    0x00, 0x00, 0x05, 0x03, 0x00, 0x00,  // '
    0x00, 0x00, 0x1c, 0x22, 0x41, 0x00,  // (
    0x00, 0x00, 0x41, 0x22, 0x1c, 0x00,  // )
    0x00, 0x14, 0x08, 0x3E, 0x08, 0x14,  // *
    0x00, 0x08, 0x08, 0x3E, 0x08, 0x08,  // +
    0x00, 0x00, 0x00, 0xA0, 0x60, 0x00,  // ,
    0x00, 0x08, 0x08, 0x08, 0x08, 0x08,  // -
    0x00, 0x00, 0x60, 0x60, 0x00, 0x00,  // .
    0x00, 0x20, 0x10, 0x08, 0x04, 0x02,  // /
    0x00, 0x3E, 0x51, 0x49, 0x45, 0x3E,  // 0
    0x00, 0x00, 0x42, 0x7F, 0x40, 0x00,  // 1
    0x00, 0x42, 0x61, 0x51, 0x49, 0x46,  // 2
    0x00, 0x21, 0x41, 0x45, 0x4B, 0x31,  // 3
    0x00, 0x18, 0x14, 0x12, 0x7F, 0x10,  // 4
    0x00, 0x27, 0x45, 0x45, 0x45, 0x39,  // 5
    0x00, 0x3C, 0x4A, 0x49, 0x49, 0x30,  // 6
    0x00, 0x01, 0x71, 0x09, 0x05, 0x03,  // 7
    0x00, 0x36, 0x49, 0x49, 0x49, 0x36,  // 8
    0x00, 0x06, 0x49, 0x49, 0x29, 0x1E,  // 9
    0x00, 0x00, 0x36, 0x36, 0x00, 0x00,  // :
    0x00, 0x00, 0x56, 0x36, 0x00, 0x00,  // ;
    0x00, 0x08, 0x14, 0x22, 0x41, 0x00,  // <
    0x00, 0x14, 0x14, 0x14, 0x14, 0x14,  // =
    0x00, 0x00, 0x41, 0x22, 0x14, 0x08,  // >
    0x00, 0x02, 0x01, 0x51, 0x09, 0x06,  // ?
    0x00, 0x32, 0x49, 0x59, 0x51, 0x3E,  // @
    0x00, 0x7C, 0x12, 0x11, 0x12, 0x7C,  // A
    0x00, 0x7F, 0x49, 0x49, 0x49, 0x36,  // B
    0x00, 0x3E, 0x41, 0x41, 0x41, 0x22,  // C
    0x00, 0x7F, 0x41, 0x41, 0x22, 0x1C,  // D
    0x00, 0x7F, 0x49, 0x49, 0x49, 0x41,  // E
    0x00, 0x7F, 0x09, 0x09, 0x09, 0x01,  // F
    0x00, 0x3E, 0x41, 0x49, 0x49, 0x7A,  // G
    0x00, 0x7F, 0x08, 0x08, 0x08, 0x7F,  // H
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
    0x14, 0x14, 0x14, 0x14, 0x14, 0x14,  // horiz lines
};

inline const unsigned char F8X16[] = {
    0x00, 0x00, 0x00, 0x00, 0x00, 0x00, 0x00, 0x00, 0x00, 0x00, 0x00, 0x00, 0x00, 0x00, 0x00, 0x00,   // sp /0
    0x00, 0x00, 0x00, 0xF8, 0x00, 0x00, 0x00, 0x00, 0x00, 0x00, 0x00, 0x33, 0x30, 0x00, 0x00, 0x00,   //!  /1
    0x00, 0x10, 0x0C, 0x06, 0x10, 0x0C, 0x06, 0x00, 0x00, 0x00, 0x00, 0x00, 0x00, 0x00, 0x00, 0x00,   //"  /2
    0x40, 0xC0, 0x78, 0x40, 0xC0, 0x78, 0x40, 0x00, 0x04, 0x3F, 0x04, 0x04, 0x3F, 0x04, 0x04, 0x00,   // #  /3
    0x00, 0x70, 0x88, 0xFC, 0x08, 0x30, 0x00, 0x00, 0x00, 0x18, 0x20, 0xFF, 0x21, 0x1E, 0x00, 0x00,   //$  /4
    0xF0, 0x08, 0xF0, 0x00, 0xE0, 0x18, 0x00, 0x00, 0x00, 0x21, 0x1C, 0x03, 0x1E, 0x21, 0x1E, 0x00,   //%  /5
    0x00, 0xF0, 0x08, 0x88, 0x70, 0x00, 0x00, 0x00, 0x1E, 0x21, 0x23, 0x24, 0x19, 0x27, 0x21, 0x10,   //&  /6
    0x10, 0x16, 0x0E, 0x00, 0x00, 0x00, 0x00, 0x00, 0x00, 0x00, 0x00, 0x00, 0x00, 0x00, 0x00, 0x00,   //'  /7
    0x00, 0x00, 0x00, 0xE0, 0x18, 0x04, 0x02, 0x00, 0x00, 0x00, 0x00, 0x07, 0x18, 0x20, 0x40, 0x00,   //(  /8
    0x00, 0x02, 0x04, 0x18, 0xE0, 0x00, 0x00, 0x00, 0x00, 0x40, 0x20, 0x18, 0x07, 0x00, 0x00, 0x00,   //)  /9
    0x40, 0x40, 0x80, 0xF0, 0x80, 0x40, 0x40, 0x00, 0x02, 0x02, 0x01, 0x0F, 0x01, 0x02, 0x02, 0x00,   //*  /10
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
        0x00, 0x7E, 0x04, 0x08, 0x10, 0x7E, 0x00, 0x7E, 0x00, 0x3C, 0x42, 0x42, 0x42, 0x42, 0x00, 0x7E, 0x42,
        0x42, 0x42, 0x7E, 0x00, 0x7E, 0x04, 0x08, 0x10, 0x7E, /*"C:\Users\HP\Desktop\UNICORN.BMP",0*/

};
