X-Green/ELEC3300-Maglev-Project-2025/maglev2025_software/Drivers/Oled.cpp

#include "Oled.hpp"

uint8_t u8x8_byte_hw_i2c(u8x8_t *u8x8, uint8_t msg, uint8_t arg_int, void *arg_ptr)
{
    /* u8g2/u8x8 will never send more than 32 bytes between START_TRANSFER and END_TRANSFER */
    static uint8_t buffer[128];
    static uint8_t buf_idx;
    uint8_t *data;

    switch (msg)
    {
    case U8X8_MSG_BYTE_INIT:
    {
        /*  init i2c subsystem */
        MX_I2C3_Init();
    }
    break;

    case U8X8_MSG_BYTE_START_TRANSFER:
    {
        buf_idx = 0;
    }
    break;

    case U8X8_MSG_BYTE_SEND:
    {
        data = (uint8_t *)arg_ptr;

        while (arg_int > 0)
        {
            buffer[buf_idx++] = *data;
            data++;
            arg_int--;
        }
    }
    break;

    case U8X8_MSG_BYTE_END_TRANSFER:
    {
        if (HAL_I2C_Master_Transmit(&hi2c3, (OLED_ADDRESS), buffer, buf_idx, 1000) != HAL_OK)
            return 0;
    }
    break;

    case U8X8_MSG_BYTE_SET_DC:
        break;

    default:
        return 0;
    }

    return 1;
}

void delay_us(uint32_t time)
{
    uint32_t i = 8 * time;
    while (i--)
        ;
}

uint8_t u8x8_gpio_and_delay(u8x8_t *u8x8, uint8_t msg, uint8_t arg_int, void *arg_ptr)
{
    switch (msg)
    {
    case U8X8_MSG_DELAY_100NANO:  // delay arg_int * 100 nano seconds
        __NOP();
        break;
    case U8X8_MSG_DELAY_10MICRO:  // delay arg_int * 10 micro seconds
        for (uint16_t n = 0; n < 320; n++)
        {
            __NOP();
        }
        break;
    case U8X8_MSG_DELAY_MILLI:  // delay arg_int * 1 milli second
        HAL_Delay(1);
        break;
    case U8X8_MSG_DELAY_I2C:  // arg_int is the I2C speed in 100KHz, e.g. 4 = 400 KHz
        delay_us(5);
        break;                     // arg_int=1: delay by 5us, arg_int = 4: delay by 1.25us
    case U8X8_MSG_GPIO_I2C_CLOCK:  // arg_int=0: Output low at I2C clock pin
        break;                     // arg_int=1: Input dir with pullup high for I2C clock pin
    case U8X8_MSG_GPIO_I2C_DATA:   // arg_int=0: Output low at I2C data pin
        break;                     // arg_int=1: Input dir with pullup high for I2C data pin
    case U8X8_MSG_GPIO_MENU_SELECT:
        u8x8_SetGPIOResult(u8x8, /* get menu select pin state */ 0);
        break;
    case U8X8_MSG_GPIO_MENU_NEXT:
        u8x8_SetGPIOResult(u8x8, /* get menu next pin state */ 0);
        break;
    case U8X8_MSG_GPIO_MENU_PREV:
        u8x8_SetGPIOResult(u8x8, /* get menu prev pin state */ 0);
        break;
    case U8X8_MSG_GPIO_MENU_HOME:
        u8x8_SetGPIOResult(u8x8, /* get menu home pin state */ 0);
        break;
    default:
        u8x8_SetGPIOResult(u8x8, 1);  // default return value
        break;
    }
    return 1;
}
void u8g2Init(u8g2_t *u8g2)
{
    u8g2_Setup_ssd1306_i2c_128x64_noname_f(u8g2, U8G2_R0, u8x8_byte_hw_i2c, u8x8_gpio_and_delay);  // 初始化 u8g2 结构体
    u8g2_InitDisplay(u8g2);      // 根据所选的芯片进行初始化工作，初始化完成后，显示器处于关闭状态
    u8g2_SetPowerSave(u8g2, 0);  // 打开显示器
    u8g2_ClearBuffer(u8g2);
}
uint8_t *DataToWave(float *data, uint8_t len, uint8_t *wave, float max, float min)
{
    // scale data to [0, 64]
    // min is the minimum value of the data, max is the maximum value of the data
    float range = max - min;
    for (uint8_t i = 0; i < len; i++)
    {
        float scaled = (data[i] - min) * 50.0f / range;
        if (scaled < 0)
            scaled = 0;
        if (scaled > 50)
            scaled = 50;
        wave[i] = (uint8_t)scaled;
    }
    return wave;
}

void DrawWave(uint8_t x, uint8_t y, uint8_t *wave, uint8_t len, u8g2_t *u8g2)
{
    for (uint8_t i = 0; i < len; i++)
    {
        u8g2_DrawPixel(u8g2, x + i, 32 + y - wave[i]);
    }
}

void updateMagnetWaveform(float newValue, float *MagnetWaveform)
{
    for (int i = 0; i < 127; i++)
    {
        MagnetWaveform[i] = MagnetWaveform[i + 1];
    }
    MagnetWaveform[127] = newValue;
}

uint8_t CMD_Data[] = {0xAE, 0xD5, 0x80, 0xA8, 0x3F, 0xD3, 0x00, 0x40, 0xA1, 0xC8, 0xDA,

                      0x12, 0x81, 0xCF, 0xD9, 0xF1, 0xDB, 0x40, 0xA4, 0xA6, 0x8D, 0x14,

                      0xAF};
// init OLED Command

namespace Drivers::Oled
{
void OLED_WR_CMD(uint8_t cmd) { HAL_I2C_Mem_Write(&hi2c3, 0x78, 0x00, I2C_MEMADD_SIZE_8BIT, &cmd, 1, 0x100); }

void OLED_Init(void)
{
    HAL_Delay(200);

    uint8_t i = 0;
    for (i = 0; i < 23; i++)
    {
        OLED_WR_CMD(CMD_Data[i]);
    }
}

void OLED_WR_DATA(uint8_t data) { HAL_I2C_Mem_Write(&hi2c3, 0x78, 0x40, I2C_MEMADD_SIZE_8BIT, &data, 1, 0x100); }

void OLED_On(void)
{
    uint8_t i, n;
    for (i = 0; i < 8; i++)
    {
        OLED_WR_CMD(0xb0 + i);  // set page address
        OLED_WR_CMD(0x00);      // set low column address
        OLED_WR_CMD(0x10);      // set high column address
        for (n = 0; n < 128; n++)
            OLED_WR_DATA(1);
    }
}
void OLED_Clear(void)
{
    uint8_t i, n;
    for (i = 0; i < 8; i++)
    {
        OLED_WR_CMD(0xb0 + i);
        OLED_WR_CMD(0x00);
        OLED_WR_CMD(0x10);
        for (n = 0; n < 128; n++)
            OLED_WR_DATA(0);
    }
}

void OLED_Display_On(void)
{
    OLED_WR_CMD(0X8D);  // SET DCDC comand
    OLED_WR_CMD(0X14);  // DCDC ON
    OLED_WR_CMD(0XAF);  // DISPLAY ON
}

void OLED_Set_Pos(uint8_t x, uint8_t y)
{
    OLED_WR_CMD(0xb0 + y);
    OLED_WR_CMD(((x & 0xf0) >> 4) | 0x10);
    OLED_WR_CMD(x & 0x0f);
}

unsigned int oled_pow(uint8_t m, uint8_t n)
{
    unsigned int result = 1;
    while (n--)
        result *= m;
    return result;
}

void OLED_ShowChar(uint8_t x, uint8_t y, uint8_t chr, uint8_t Char_Size, uint8_t Color_Turn)
{
    unsigned char c = 0, i = 0;
    c = chr - ' ';
    if (x > 128 - 1)
    {
        x = 0;
        y = y + 2;
    }
    if (Char_Size == 16)
    {
        OLED_Set_Pos(x, y);
        for (i = 0; i < 8; i++)
        {
            if (Color_Turn)
                OLED_WR_DATA(~F8X16[c * 16 + i]);
            else
                OLED_WR_DATA(F8X16[c * 16 + i]);
        }
        OLED_Set_Pos(x, y + 1);
        for (i = 0; i < 8; i++)
        {
            if (Color_Turn)
                OLED_WR_DATA(~F8X16[c * 16 + i + 8]);
            else
                OLED_WR_DATA(F8X16[c * 16 + i + 8]);
        }
    }
    else
    {
        OLED_Set_Pos(x, y);
        for (i = 0; i < 6; i++)
        {
            if (Color_Turn)
                OLED_WR_DATA(~F6x8[c][i]);
            else
                OLED_WR_DATA(F6x8[c][i]);
        }
    }
}
void OLED_ShowNum(uint8_t x, uint8_t y, unsigned int num, uint8_t len, uint8_t size2, uint8_t Color_Turn)
{
    uint8_t t, temp;
    uint8_t enshow = 0;
    for (t = 0; t < len; t++)
    {
        temp = (num / oled_pow(10, len - t - 1)) % 10;
        if (enshow == 0 && t < (len - 1))
        {
            if (temp == 0)
            {
                OLED_ShowChar(x + (size2 / 2) * t, y, ' ', size2, Color_Turn);
                continue;
            }
            else
                enshow = 1;
        }
        OLED_ShowChar(x + (size2 / 2) * t, y, temp + '0', size2, Color_Turn);
    }
}
void OLED_DrawBMP(uint8_t x0, uint8_t y0, uint8_t x1, uint8_t y1, uint8_t *BMP, uint8_t Color_Turn)
{
    uint32_t j = 0;
    uint8_t x = 0, y = 0;

    if (y1 % 8 == 0)
        y = y1 / 8;
    else
        y = y1 / 8 + 1;
    for (y = y0; y < y1; y++)
    {
        OLED_Set_Pos(x0, y);
        for (x = x0; x < x1; x++)
        {
            if (Color_Turn)
                OLED_WR_DATA(~BMP[j++]);  // 显示反相图片
            else
                OLED_WR_DATA(BMP[j++]);  // 显示图片
        }
    }
}
}  // namespace Drivers::Oled
