X-Green/ELEC3300-Maglev-Project-2025/maglev2025_software/Drivers/WS2812.cpp

#include "WS2812.hpp"

#include "tim.h"

namespace Drivers::WS2812
{

void RGB::toBitSequence(uint32_t *bitSequence) const
{
    for (int i = 0; i < 8; i++)
    {
        // Total counter for timer is 5 with period around 1us
        // hence 4/5 will be recognized as 1, 1/5 will be recognized as 0 (4/5 and 1/5 for duty cycle)
        // check manuals of ws2812 for more details
        bitSequence[i]      = (green & (1 << (7 - i))) ? WS2812_BIT1_WIDTH : WS2812_BIT0_WIDTH;
        bitSequence[i + 8]  = (red & (1 << (7 - i))) ? WS2812_BIT1_WIDTH : WS2812_BIT0_WIDTH;
        bitSequence[i + 16] = (blue & (1 << (7 - i))) ? WS2812_BIT1_WIDTH : WS2812_BIT0_WIDTH;
    }
}

void init() { HAL_TIM_PWM_Start_DMA(&htim2, TIM_CHANNEL_2, CCRDMABuff, LED_NUM * 24 + RESET_COUNT); }

void setColor(int index, unsigned char r, unsigned char g, unsigned char b)
{
    if (!isInited)
    {
        init();
        isInited = true;
    }
    RGB rgb(r, g, b);
    rgb.toBitSequence(CCRDMABuff + index * 24);
}
void setColor(int index, RGB color)
{
    if (!isInited)
    {
        init();
        isInited = true;
    }
    color.toBitSequence(CCRDMABuff + index * 24);
}

void setColor(int index, RGB color, float brightness)
{
    if (!isInited)
    {
        init();
        isInited = true;
    }
    RGB colorNew = RGB(color.red * brightness, color.green * brightness, color.blue * brightness);
    colorNew.toBitSequence(CCRDMABuff + index * 24);
}

void blank(int index)
{
    for (int i = 0; i < 24; i++)
    {
        RGB rgb(0, 0, 0);
        rgb.toBitSequence(CCRDMABuff + index * 24);
    }
}

void blankAll()
{
    if (!isInited)
    {
        init();
        isInited = true;
    }
    for (int i = 0; i < LED_NUM; i++)
    {
        blank(i);
    }
}

}  // namespace Drivers::WS2812
