X-Green/ELEC3300-Maglev-Project-2025/maglev2025_software/Tasks/SampleTasks.hpp

//
// Created by eeasee on 3/12/25.
//

#pragma once
#include "main.h"
#include "CoilManager.hpp"

namespace Tasks::SampleTask
{

void sampleTaskInit();

void callbackHRTIM();

void callbackNormal();

}  // namespace Tasks::SampleTask
