X-Green/ELEC3300-Maglev-Project-2025/(commit log)

2025-03-03 hardware init
    [maglev2025_hardware_test1.kicad_pcb, maglev2025_hardware_test1.kicad_sch]
2025-03-05 schemetic and pin assignment
    [maglev2025_hardware_test1.kicad_sch]
2025-03-06 Update schematic and ioc
    [maglev2025_hardware_test1.kicad_sch]
2025-03-06 Layout mostly done
    [maglev2025_hardware_test1.kicad_pcb, maglev2025_hardware_test1.kicad_sch]
2025-03-08 Layout routing done, checking test
    [maglev2025_hardware_test1.kicad_pcb, maglev2025_hardware_test1.kicad_sch]
2025-03-08 Almost Complete
    [maglev2025_hardware_test1.kicad_pcb, maglev2025_hardware_test1.kicad_sch]
2025-03-08 ver 0.1 sent to fabrication
    [maglev2025_hardware_test1.kicad_pcb]
2025-03-11 power input states
2025-03-16 Update PCB for soldering; Fix schematic bug (SWD Pin)
    [maglev2025_hardware_test1.kicad_pcb, maglev2025_hardware_test1.kicad_sch]
2025-03-16 Adjust ioc: RCC 12MHz, VRef 2.90V; Regenerated Code
2025-03-16 Modify HRTIM and ADC triggering; Generated Code; Should work
2025-03-18 fixed, can compile successfully
    [TMAG5170.cpp, TMAG5170.hpp]
2025-03-19 debug spi
2025-03-20 winwinwin, sensor can read
2025-04-08 Setup Interrupt handlers
2025-04-08 Add logic for DMA sequential read
2025-04-09 Fix bug on namespace and C extern
    [MainTasks.cpp, PositionControl.cpp, TMAG5170.cpp]
2025-04-09 Change SPI speed
2025-04-09 Add 1kHz timer; Add logging; Change sample rate of TMAG5170
2025-04-10 Successfully use DMA to read Mag Data........
2025-04-11 successfully output pwm
2025-04-11 Can read ADC from DMA; Slower HRTIM 2x into 42500Hz
2025-04-12 Don't use cassert, use assert_param from stm32hal
2025-04-12 CoilCurrentControl seems okay; Changed from INA240A4 to INA240A1, noise get a lot lot better
    [CoilManager.cpp, MainTasks.cpp, SampleTask.cpp, SampleTask.hpp, TMAG5170.cpp, maglev2025_software.ioc]
2025-04-14 init hardware test2
    [maglev2025_hardware_test2.kicad_pcb, maglev2025_hardware_test2.kicad_sch, untitled.kicad_sch]
2025-04-16 finish test2 sche
    [Base_board_3DP.SLDPRT, maglev2025_hardware_test2.kicad_pcb, maglev2025_hardware_test2.kicad_sch, untitled.kicad_sch]
2025-04-16 Fix on test 2 schematic
    [maglev2025_hardware_test2.kicad_sch, untitled.kicad_sch]
2025-04-18 start layout
    [maglev2025_hardware_test2.kicad_pcb, maglev2025_hardware_test2.kicad_sch]
2025-04-22 addjust layout
    [maglev2025_hardware_test2.kicad_pcb, maglev2025_hardware_test2.kicad_sch, untitled.kicad_sch]
2025-04-22 change adc pin out
    [maglev2025_hardware_test2.kicad_pcb, maglev2025_hardware_test2.kicad_sch]
2025-04-22 finish wiring
    [maglev2025_hardware_test2.kicad_pcb]
2025-04-22 finish layout, checking in progress
    [maglev2025_hardware_test2.kicad_pcb, maglev2025_hardware_test2.kicad_sch]
2025-04-23 adding external hal connector
    [maglev2025_hardware_test2.kicad_pcb, maglev2025_hardware_test2.kicad_sch]
2025-04-23 finished hal sensor board
    [maglev2025_hardware_sensor.kicad_pcb, maglev2025_hardware_sensor.kicad_sch]
2025-04-24 modify layout
    [maglev2025_hardware_test2.kicad_pcb, maglev2025_hardware_test2.kicad_sch]
2025-04-24 solve merge problem
    [maglev2025_hardware_sensor.kicad_pcb, maglev2025_hardware_sensor.kicad_sch]
2025-05-02 Fix compilation error in linux
    [MainTasks.cpp]
2025-05-02 config ADC and regenerate files
2025-05-02 Add 2812 Driver
2025-05-03 Init code of Rotary Encoder TIM8 Combined Mode
2025-05-03 Prepare UART Rx DMA setup; test pending
2025-05-03 Buzzer & IOC & uart DMA & Namespace
    [Buzzer.hpp, MainTasks.cpp, WS2812.cpp, WS2812.hpp, maglev2025_software.ioc]
2025-05-03 Fix TIM17 Update IRQ so that only corresponding event will trigger callback
    [MainTasks.cpp, maglev2025_software.ioc]
2025-05-05 Change PID class and param
2025-05-05 Config ADC and OPAMP in new setup
2025-05-05 Fix static void in header
    [WS2812.cpp, WS2812.hpp]
2025-05-05 Fix RCC and GPIO for nAlart
    [ErrorChecker.hpp, MainTasks.cpp, TMAG5170.cpp, maglev2025_software.ioc, main.h]
2025-05-05 Buzzer, LED, Encoder, ErrorChecker
    [CommandInput.cpp, ErrorChecker.cpp, ErrorChecker.hpp, MainTasks.cpp, PositionControl.cpp, SampleTask.cpp, WS2812.cpp]
2025-05-05 Add music buzzer init
    [MainTasks.cpp, TMAG5170.cpp]
2025-05-06 change adc1 sample time
2025-05-06 Try to use unblocking play buzzer
    [MainTasks.cpp, MusicTasks.cpp, MusicTasks.hpp]
