X-Green/ELEC3300-Maglev-Project-2025/(notices)

Notices in the files:
maglev2025_software/Core/Inc/main.h:
Copyright (c) 2025 STMicroelectronics.
All rights reserved.
This software is licensed under terms that can be found in the LICENSE file
